kasbah/nomech_mini-hw/(commit log)

2013-04-09 doing basic layout estimation
    [nomech_mini.kicad_pcb]
2013-04-09 trying out LED position
    [nomech_mini.kicad_pcb]
2013-04-09 starting schematic, adjusting pcb
    [LEDS.sch, nomech_mini.kicad_pcb, nomech_mini.sch]
2013-04-09 starting LED array, adjusting PCB
    [LEDS.sch, nomech_mini.kicad_pcb, nomech_mini.sch]
2013-04-10 working mainly on LEDs
    [LEDS.sch, nomech_mini.kicad_pcb, nomech_mini.sch]
2013-04-10 messing about with elctrode
    [nomech_mini.kicad_pcb]
2013-04-10 adding netlist, just for messing with footprints
    [nomech_mini.kicad_pcb]
2013-04-10 commiting before change to LED numbers
    [LEDS.sch, nomech_mini.kicad_pcb, nomech_mini.sch]
2013-04-10 removing LEDs, adding switch
    [LEDS.sch, nomech_mini.sch]
2013-04-11 starting layout
    [LEDS.sch, nomech_mini.kicad_pcb, nomech_mini.sch]
2013-04-11 laying out LEDs
    [nomech_mini.kicad_pcb]
2013-04-12 placing LEDS, working out laser cutting
    [LEDS.sch, nomech_mini.kicad_pcb, nomech_mini.sch]
2013-04-12 messing about with edge-cuts, putting them in .mod
    [nomech_mini.kicad_pcb]
2013-04-12 doing cutouts in the electrode module
    [nomech_mini.kicad_pcb]
2013-04-12 most Rs placed
    [nomech_mini.kicad_pcb]
2013-04-13 starting routing...
    [nomech_mini.kicad_pcb]
2013-04-13 changing electrode
    [nomech_mini.kicad_pcb]
2013-05-07 laying out 4 types of LED+electrode combos
    [LEDS.sch, nomech_mini.kicad_pcb, nomech_mini.sch]
2013-05-07 starting to route
    [nomech_mini.kicad_pcb]
2013-05-07 routing fan-out of atmega
    [nomech_mini.kicad_pcb]
2013-05-08 switching MCU and analog stuff
    [nomech_mini.kicad_pcb]
2013-05-08 grounding first
    [nomech_mini.kicad_pcb]
2013-05-14 changing electrodes to use fills, routing...
    [nomech_mini.kicad_pcb]
2013-05-14 settling on reverseLED and flipping everything
    [nomech_mini.kicad_pcb]
2013-05-29 routing at 45 degrees
    [nomech_mini.kicad_pcb]
2013-05-29 routing, paying attention to looks on top layer
    [LEDS.sch, nomech_mini.kicad_pcb, nomech_mini.sch]
2013-05-29 routing... ugly but nice
    [nomech_mini.kicad_pcb, nomech_mini.sch]
2013-05-29 routing... nicely
    [nomech_mini.kicad_pcb, nomech_mini.sch]
2013-06-04 routing.. SPI done
    [LEDS.sch, nomech_mini.kicad_pcb, nomech_mini.sch]
2013-06-04 SPI tear-up and re-route
    [nomech_mini.kicad_pcb]
2013-06-06 routing, grounds on outside
    [LEDS.sch, nomech_mini.kicad_pcb, nomech_mini.sch]
2013-06-07 routing, smaller ground plane
    [nomech_mini.kicad_pcb]
2013-06-10 adding BOM, routing... ground planes
    [nomech_mini.csv, nomech_mini.kicad_pcb]
2013-06-10 some minor placing and routing corrections
    [nomech_mini.kicad_pcb]
2013-06-10 flipped the whole board, final touches 0.1-alpha
    [nomech_mini.kicad_pcb]
2013-06-10 adding gerbers and license
    [nomech_mini-B_Paste.gbp, nomech_mini-Back.gbl, nomech_mini-Dwgs_User.gbr, nomech_mini-Edge_Cuts.gbr, nomech_mini-F_Paste.gtp, nomech_mini-F_SilkS.gto, nomech_mini-Front.gtl, nomech_mini-NPTH.drl]
2013-06-12 stitching ground plane, checking gerbers
    [nomech_mini-B_Paste.gbp, nomech_mini-Back.gbl, nomech_mini-Dwgs_User.gbr, nomech_mini-Edge_Cuts.gbr, nomech_mini-F_Paste.gtp, nomech_mini-F_SilkS.gto, nomech_mini-Front.gtl, nomech_mini-NPTH.drl]
2013-06-12 hiding some text, updating gerbers
    [nomech_mini-B_Mask.gbs, nomech_mini-Back.gbl, nomech_mini-Edge_Cuts.gbr, nomech_mini-F_Mask.gts, nomech_mini-F_Paste.gtp, nomech_mini-F_SilkS.gto, nomech_mini-Front.gtl, nomech_mini-NPTH.drl]
